Virtex7/Mugelcontroller/README.md

# Mugelcontroller
kleiner 12V-Umrichter für einen Secop-BD50 Kältekompressor
