Virtex7/Mugelcontroller/PCB/report.txt

Info: Backing up file "/home/philipp/Dokumente/dev/Mugelcontroller/PCB/sym-lib-table" to file "/home/philipp/Dokumente/dev/Mugelcontroller/PCB/rescue-backup/sym-lib-table-2019-11-03-22-35-38".
Info: Backing up file "/home/philipp/Dokumente/dev/Mugelcontroller/PCB/A4960 Devboard.sch" to file "/home/philipp/Dokumente/dev/Mugelcontroller/PCB/rescue-backup/A4960 Devboard-2019-11-03-22-35-38.sch".
Info: Backing up file "/home/philipp/Dokumente/dev/Mugelcontroller/PCB/A4960 Devboard.pro" to file "/home/philipp/Dokumente/dev/Mugelcontroller/PCB/rescue-backup/A4960 Devboard-2019-11-03-22-35-38.pro".
Info: Backing up file "/home/philipp/Dokumente/dev/Mugelcontroller/PCB/A4960 Devboard-cache.lib" to file "/home/philipp/Dokumente/dev/Mugelcontroller/PCB/rescue-backup/A4960 Devboard-cache-2019-11-03-22-35-38.lib".
Info: Backing up file "/home/philipp/Dokumente/dev/Mugelcontroller/PCB/A4960 Devboard-rescue.lib" to file "/home/philipp/Dokumente/dev/Mugelcontroller/PCB/rescue-backup/A4960 Devboard-rescue-2019-11-03-22-35-38.lib".
Info: Backing up file "/home/philipp/Dokumente/dev/Mugelcontroller/PCB/A4960 Devboard-rescue.dcm" to file "/home/philipp/Dokumente/dev/Mugelcontroller/PCB/rescue-backup/A4960 Devboard-rescue-2019-11-03-22-35-38.dcm".
Info: Adding library "A4960-Devboard-rescue", file "${KIPRJMOD}/A4960 Devboard-rescue.lib" to project symbol library table.
Info: Adding library "ph-motor", file "/home/philipp/Dokumente/dev/PhilippsKicadBauteile/Schaltplansymbole/ph-motor.lib" to project symbol library table.
Info: Adding library "Resonator_3pins", file "/home/philipp/Dokumente/dev/PhilippsKicadBauteile/Schaltplansymbole/Resonator_3pins.lib" to project symbol library table.
Symbol "A4960" mapped to symbol library "ph-motor".
Symbol "C" mapped to symbol library "A4960-Devboard-rescue".
Symbol "R" mapped to symbol library "A4960-Devboard-rescue".
Symbol "R" mapped to symbol library "A4960-Devboard-rescue".
Symbol "C" mapped to symbol library "A4960-Devboard-rescue".
Symbol "VPP" mapped to symbol library "A4960-Devboard-rescue".
Symbol "C" mapped to symbol library "A4960-Devboard-rescue".
Symbol "C" mapped to symbol library "A4960-Devboard-rescue".
Symbol "C" mapped to symbol library "A4960-Devboard-rescue".
Symbol "VPP" mapped to symbol library "A4960-Devboard-rescue".
Symbol "GND" mapped to symbol library "A4960-Devboard-rescue".
Symbol "GND" mapped to symbol library "A4960-Devboard-rescue".
Symbol "GND" mapped to symbol library "A4960-Devboard-rescue".
Symbol "GND" mapped to symbol library "A4960-Devboard-rescue".
Symbol "GND" mapped to symbol library "A4960-Devboard-rescue".
Symbol "GND" mapped to symbol library "A4960-Devboard-rescue".
Symbol "VPP" mapped to symbol library "A4960-Devboard-rescue".
Symbol "C" mapped to symbol library "A4960-Devboard-rescue".
Symbol "C" mapped to symbol library "A4960-Devboard-rescue".
Symbol "GND" mapped to symbol library "A4960-Devboard-rescue".
Symbol "C" mapped to symbol library "A4960-Devboard-rescue".
Symbol "R" mapped to symbol library "A4960-Devboard-rescue".
Symbol "R" mapped to symbol library "A4960-Devboard-rescue".
Symbol "VPP" mapped to symbol library "A4960-Devboard-rescue".
Symbol "C" mapped to symbol library "A4960-Devboard-rescue".
Symbol "R" mapped to symbol library "A4960-Devboard-rescue".
Symbol "R" mapped to symbol library "A4960-Devboard-rescue".
Symbol "VPP" mapped to symbol library "A4960-Devboard-rescue".
Symbol "R" mapped to symbol library "A4960-Devboard-rescue".
Symbol "GND" mapped to symbol library "A4960-Devboard-rescue".
Symbol "VPP" mapped to symbol library "A4960-Devboard-rescue".
Symbol "GND" mapped to symbol library "A4960-Devboard-rescue".
Symbol "C" mapped to symbol library "A4960-Devboard-rescue".
Symbol "CP" mapped to symbol library "A4960-Devboard-rescue".
Symbol "GND" mapped to symbol library "A4960-Devboard-rescue".
Symbol "VPP" mapped to symbol library "A4960-Devboard-rescue".
Symbol "VPP" mapped to symbol library "A4960-Devboard-rescue".
Symbol "ATMEGA8-AI" mapped to symbol library "A4960-Devboard-rescue".
Symbol "RESONATEUR" mapped to symbol library "Resonator_3pins".
Symbol "GND" mapped to symbol library "A4960-Devboard-rescue".
Symbol "GND" mapped to symbol library "A4960-Devboard-rescue".
Symbol "GND" mapped to symbol library "A4960-Devboard-rescue".
Symbol "R" mapped to symbol library "A4960-Devboard-rescue".
Symbol "C" mapped to symbol library "A4960-Devboard-rescue".
Symbol "C" mapped to symbol library "A4960-Devboard-rescue".
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
Symbol "+5V" mapped to symbol library "A4960-Devboard-rescue".
Symbol "AP1117D50" mapped to symbol library "A4960-Devboard-rescue".
Symbol "C" mapped to symbol library "A4960-Devboard-rescue".
Symbol "R" mapped to symbol library "A4960-Devboard-rescue".
Symbol "VPP" mapped to symbol library "A4960-Devboard-rescue".
Symbol "+5V" mapped to symbol library "A4960-Devboard-rescue".
Symbol "GND" mapped to symbol library "A4960-Devboard-rescue".
Symbol "R" mapped to symbol library "A4960-Devboard-rescue".
Symbol "+5V" mapped to symbol library "A4960-Devboard-rescue".
Symbol "GND" mapped to symbol library "A4960-Devboard-rescue".
Info: Symbol library table mapping complete!
