Virtex7/Mugelcontroller/PCB/A4960 Devboard.kicad_pcb

## KiCad design PCB/A4960 Devboard.kicad_pcb (2021-04-13)

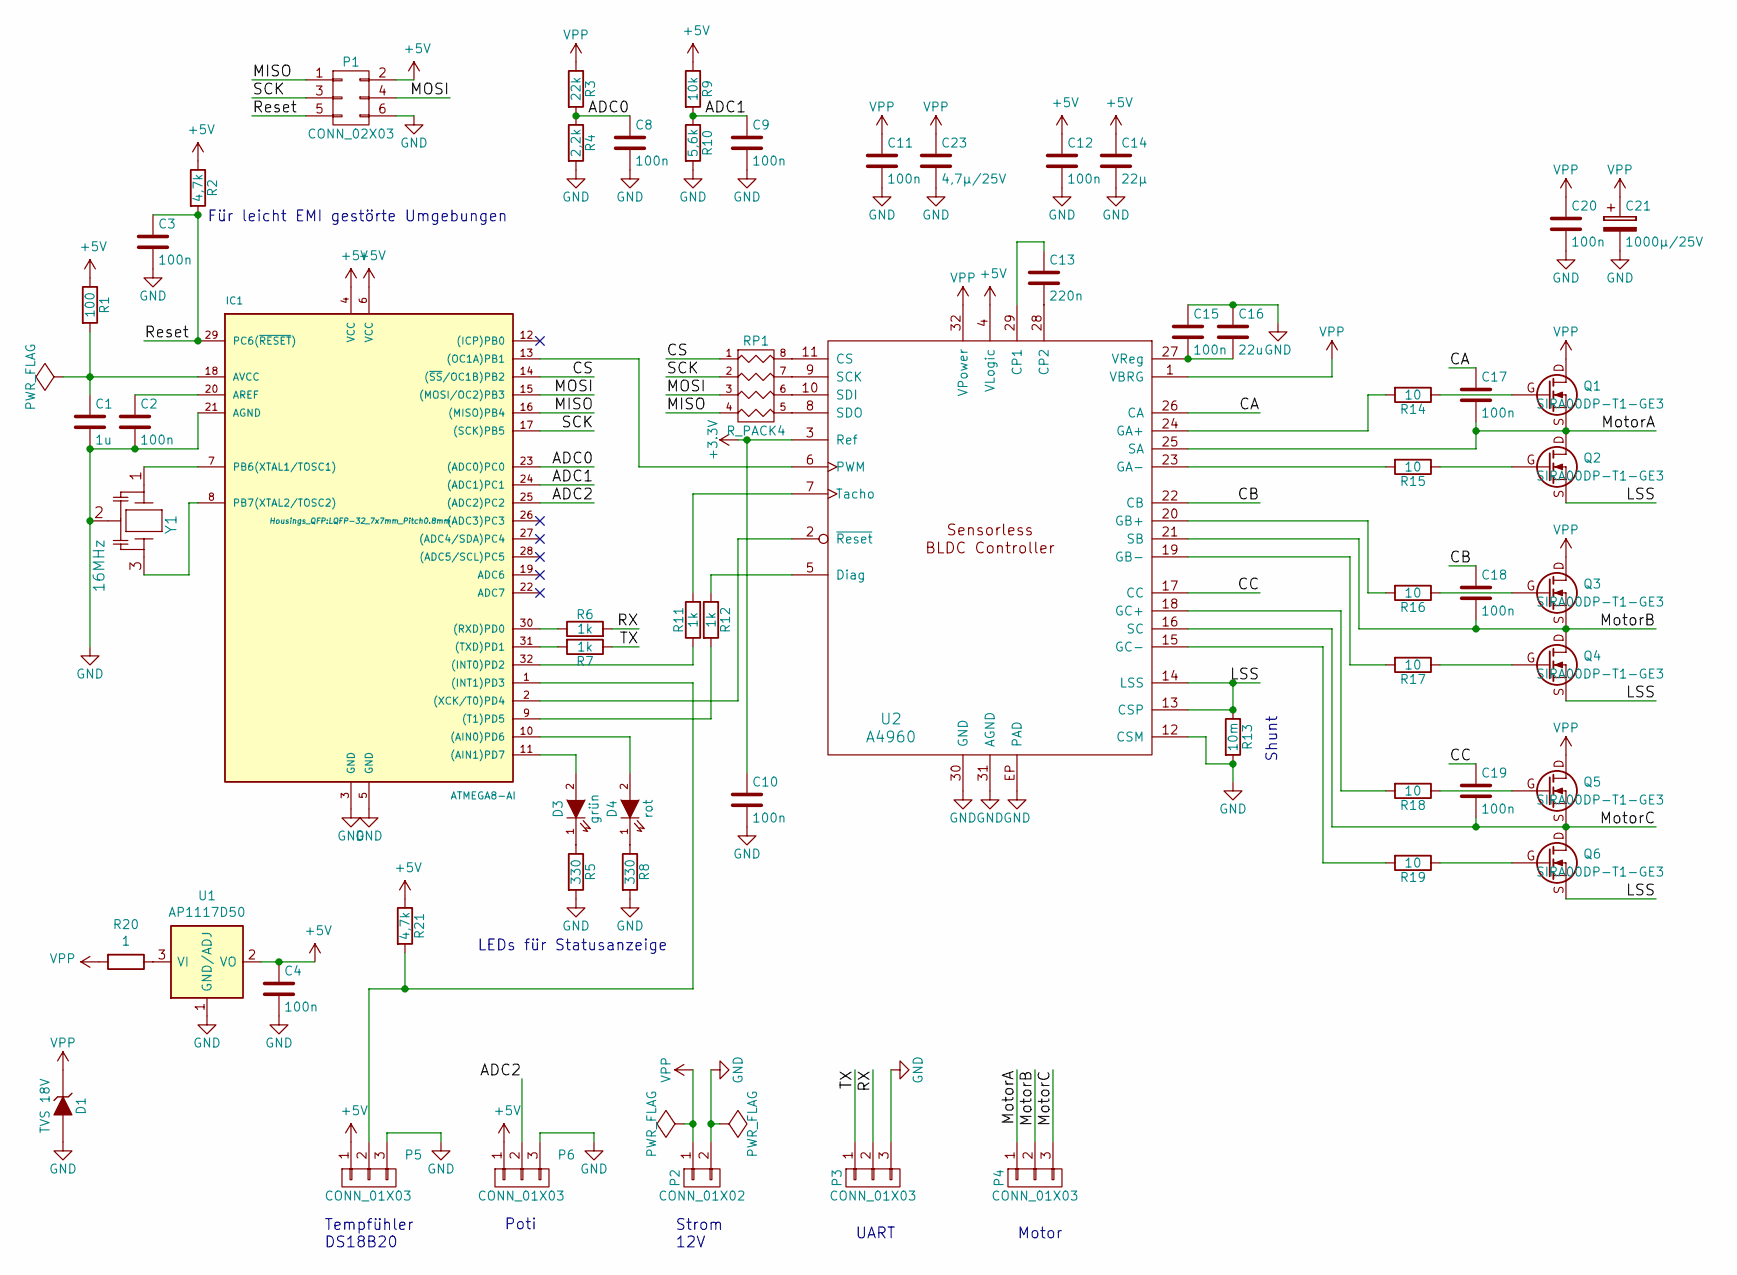
[picture p1: schematic A4960 Devboard.kicad_sch]

Parts:
C1: 1u; C_0603
C2, C3, C4, C8, C9, C10, C11, C12, C15, C17, C18, C19, C20: 100n; C_0603
C13: 220n; C_0603
C14: 22µ; C_1206
C16: 22u; C_1206
C21: 1000µ/25V; C_Radial_D8_L11.5_P3.5
C23: 4,7µ/25V; C_1206
D1: TVS 18V; SOD-123
D3: grün; LED-0603
D4: rot; LED-0603
IC1: ATMEGA8-AI; LQFP-32_7x7mm_Pitch0.8mm
P1: CONN_02X03; Pin_Header_Straight_2x03
P2: CONN_01X02; Pin_Header_Straight_1x02
P3, P4, P5, P6: CONN_01X03; Pin_Header_Straight_1x03
Q1, Q2, Q3, Q4, Q5, Q6: SIRA00DP-T1-GE3; SO8_WITH_Heatpipes_New
R1: 100; R_0603
R2, R21: 4,7k; R_0603
R3: 22k; R_0603
R4: 2,2k; R_0603
R5, R8: 330; R_0603
R6, R7, R11, R12: 1k; R_0603
R9: 10k; R_0603
R10: 5,6k; R_0603
R13: 10m; R_2512; Digikey-Nummer RHM.010AUCT-ND
R14, R15, R16, R17, R18, R19: 10; R_0603
R20: 1; R_0805
RP1: R_PACK4; R_Array_Concave_4x0603
U1: AP1117D50; SOT-223
U2: A4960; TQFP-32_7x7mm_Pitch0.8mm; Digikey-Nummer 620-1452-1-ND
Y1: 16MHz; CerOsc_3,2x1,3

Connections:
/ADC0: C8.1, IC1.23 ((ADC0)PC0), R3.2, R4.1
/ADC1: C9.1, IC1.24 ((ADC1)PC1), R9.2, R10.1
/CA: C17.1, U2.26 (CA)
/CB: C18.1, U2.22 (CB)
/CC: C19.1, U2.17 (CC)
/CS: IC1.14 ((~SS~/OC1B)PB2), RP1.1
/LSS: Q2.S, Q4.S, Q6.S, R13.1, U2.13 (CSP), U2.14 (LSS)
/MISO: IC1.16 ((MISO)PB4), P1.1, RP1.4
/MOSI: IC1.15 ((MOSI/OC2)PB3), P1.4, RP1.3
/MotorA: C17.2, P4.1, Q1.S, Q2.D, U2.25 (SA)
/MotorB: C18.2, P4.2, Q3.S, Q4.D, U2.21 (SB)
/MotorC: C19.2, P4.3, Q5.S, Q6.D, U2.16 (SC)
/RX: P3.2, R6.2
/Reset: C3.1, IC1.29 (PC6(~RESET~)), P1.5, R2.2
/SCK: IC1.17 ((SCK)PB5), P1.3, RP1.2
/TX: P3.1, R7.1
GND: C1.2, C2.2, C3.2, C4.2, C8.2, C9.2, C10.2, C11.2, C12.2, C14.2, C15.1, C16.1, C20.2, C21.2, C23.2, D1.2 (A), IC1.3 (GND), IC1.5 (GND), IC1.21 (AGND), P1.6, P2.2, P3.3, P5.3, P6.3, R4.2, R5.2, R8.2, R10.2, R13.2, U1.1 (GND/ADJ), U2.12 (CSM), U2.30 (GND), U2.31 (AGND), U2.EP (PAD), Y1.2
unnamed: C1.1, IC1.18 (AVCC), R1.2
unnamed: C2.1, IC1.20 (AREF)
unnamed: C13.1, U2.29 (CP1)
unnamed: C13.2, U2.28 (CP2)
unnamed: C15.2, C16.2, U2.27 (VReg)
unnamed: D3.1 (K), R5.1
unnamed: D3.2 (A), IC1.11 ((AIN1)PD7)
unnamed: D4.1 (K), R8.1
unnamed: D4.2 (A), IC1.10 ((AIN0)PD6)
unnamed: IC1.2 ((XCK/T0)PD4), U2.2 (~Reset)
unnamed: IC1.7 (PB6(XTAL1/TOSC1)), Y1.1
unnamed: IC1.8 (PB7(XTAL2/TOSC2)), Y1.3
unnamed: IC1.13 ((OC1A)PB1), U2.6 (PWM)
unnamed: IC1.25 ((ADC2)PC2), P6.2
unnamed: IC1.30 ((RXD)PD0), R6.1
unnamed: IC1.31 ((TXD)PD1), R7.2
unnamed: IC1.32 ((INT0)PD2), R11.1
unnamed: Q1.G, R14.1
unnamed: Q2.G, R15.1
unnamed: Q3.G, R16.1
unnamed: Q4.G, R17.1
unnamed: Q5.G, R18.1
unnamed: Q6.G, R19.1
unnamed: R11.2, U2.7 (Tacho)
unnamed: R12.1, U2.5 (Diag)
unnamed: R14.2, U2.24 (GA+)
unnamed: R15.2, U2.23 (GA-)
unnamed: R16.2, U2.20 (GB+)
unnamed: R17.2, U2.19 (GB-)
unnamed: R18.2, U2.18 (GC+)
unnamed: R19.2, U2.15 (GC-)
unnamed: R20.1, U1.3 (VI)
unnamed: RP1.5 (R4), U2.8 (SDO)
unnamed: RP1.6 (R3), U2.10 (SDI)
unnamed: RP1.7 (R2), U2.9 (SCK)
unnamed: RP1.8 (R1), U2.11 (CS)
VPP: C11.1, C20.1, C21.1, C23.1, D1.1 (K), P2.1, Q1.D, Q3.D, Q5.D, R3.1, R20.2, U2.1 (VBRG), U2.32 (VPower)

Notes on the sheet:
Für leicht EMI gestörte Umgebungen
Tempfühler DS18B20
LEDs für Statusanzeige
Poti
Strom 12V
UART
Motor
Shunt

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
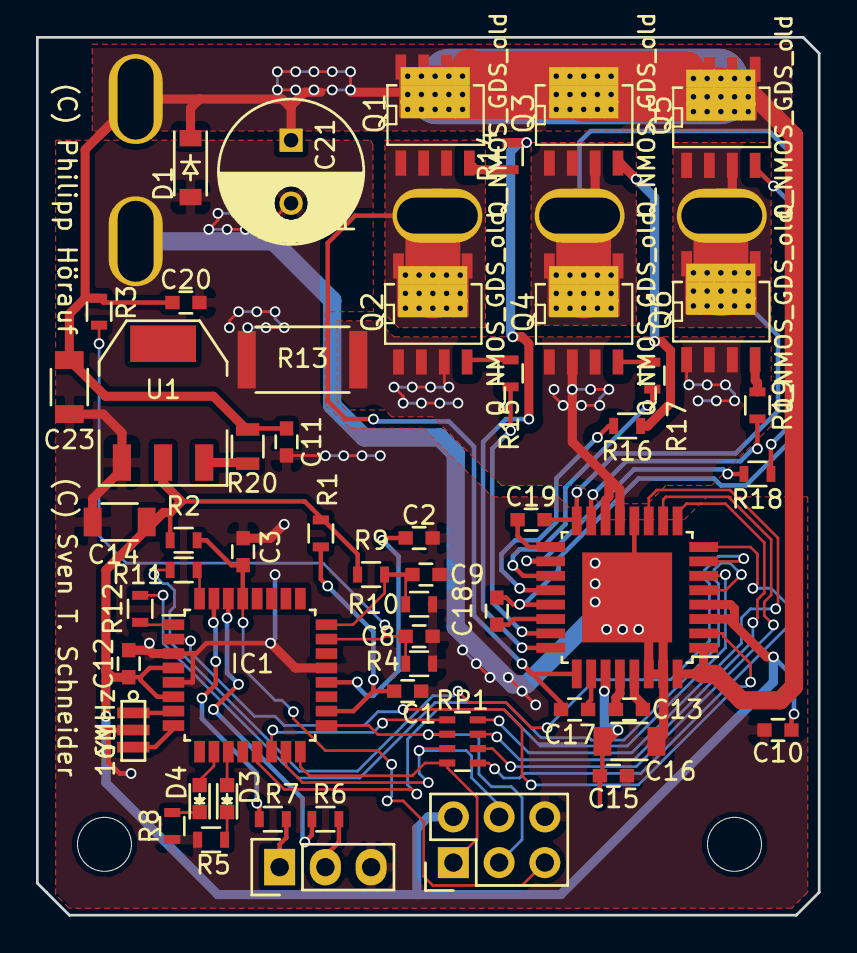
[picture p2: board A4960 Devboard.kicad_pcb from above]

Board: 2 copper layers, 43.4 x 48.8 mm, 58 parts (0 on the bottom side), 55 nets.

Other parts of the board:
Mount: MountingHole_3mm
Mount#2: MountingHole_3mm
