Virtex7/Mugelcontroller/(threads)

Thread 1 (2015-11-28):

Spannungswandler

Tynogc, 2015-11-28:
Spannungswandler prüfen:
Aktuell LD1117 5V, eventuell ändern auf Schaltwandler oder auf gleiches Bauteil wie im ESC.
Wichtig: für Kompatibilität mit dem ESC auf Pinnout achten (PIN 2 = GND).

Tynogc, 2015-12-03:
Erledigt! Wandler auf ESC geändert!

Closed 2015-12-03.
