Virtex7/Mugelcontroller/(commit log)

2015-09-07 Datenblätter von Controller und Orginal-Umrichter
2015-11-20 Library-Refferenz geändert & Layout: Vcc von 3.3V auf 5V
    [A4960 Devboard.sch]
2015-11-23 PCB angefangen
    [A4960 Devboard.kicad_pcb, A4960 Devboard.sch]
2015-11-23 Änderung der FETs auf Pinnamen GDS
    [A4960 Devboard.sch]
2015-11-26 PCB weiter
    [A4960 Devboard.kicad_pcb]
2015-11-26 V REF liegt nun auf 5V weil Datenblatt
    [A4960 Devboard.sch]
2015-11-27 PCB weiter gemcht & neuer Spannungswandler auf 5V
    [A4960 Devboard.kicad_pcb, A4960 Devboard.sch]
2015-11-30 PCB fertig!
    [A4960 Devboard.kicad_pcb, A4960 Devboard.sch]
2015-11-30 Vcc-Fläche oben eingefügt.
    [A4960 Devboard.kicad_pcb]
2015-11-30 Mehr Vias!
    [A4960 Devboard.kicad_pcb]
2015-12-04 Bestückungsdruck und Befestigungsbohrungen
    [A4960 Devboard.kicad_pcb]
2015-12-04 Lötstopplack auf unterseite teilweise entfernt
    [A4960 Devboard.kicad_pcb]
2015-12-04 Q3 war nicht richtig angeschlossen...
    [A4960 Devboard.kicad_pcb]
2015-12-07 PowerPole-Stecker korrigiert
    [A4960 Devboard.kicad_pcb, A4960 Devboard.sch]
2015-12-07 Credits angegeben
    [A4960 Devboard.kicad_pcb]
2015-12-23 neue Datenblätter für den FU-Chip und das Target.
2015-12-23 Leiterplatte so gefertigt
    [A4960 Devboard.kicad_pcb, A4960 Devboard.sch]
2015-12-24 Pr0gramm angefangen, Umrichter versucht anzulaufen. aufspaltung in umrichter.h und umrichter.c, damit Ordnung herrscht.
    [A4960 Devboard.sch]
2015-12-26 Schaltplan: fehlende Bauteilwerte eingetragen Programm: Motor läuft an. jetzt fehlen noch Regelung und diverse ADC/Timer-Auswertungen
    [A4960 Devboard.sch]
2015-12-26 float-printf aktiviert, achtung, speicherverbrauch!
2015-12-27 PI Regler leicht angepasst, dazu eine Steuermöglichkeit über die Konsole integriert, x stoppt den Motor nun sofort.
2016-02-20 fehlende zwei Anschlüsse hinzugefügt.
    [A4960 Devboard.sch]
2016-02-20 Pullup für DS18B20 Tempsensor hinzugefügt.
    [A4960 Devboard.sch]
2016-04-12 Neue Bauteile eingefügt und angeschlossen
    [A4960 Devboard.kicad_pcb]
2016-04-15 Vref auf 5V gelegt und PCB fertig gelayoutet
    [A4960 Devboard.kicad_pcb, A4960 Devboard.sch]
2021-04-13 last commit des "alten" Standes von 2016
    [A4960 Devboard.kicad_pcb, A4960 Devboard.sch]
2021-04-13 neue KiCAD Dateien ohne BACKUPS hinzugefügt
    [A4960 Devboard.kicad_sch]
